namezis/WioLTE_Cat_NB1_Eagle/README.md

# WioLTE_Cat_NB1_Documents

Split [Wio LTE Cat NB1 v1.02.sch](https://github.com/namezis/WioLTE_Cat_NB1_Eagle/blob/master/eagle/Wio%20LTE%20Cat%20NB1%20v1.02%20-%20Schematic%20-%20ANNOTATE.pdf) into seperate pages.
