namezis/WioLTE_Cat_NB1_Eagle/eagle/Wio LTE Cat NB1 v1.02 - Page 1 - CHARGER.pdf

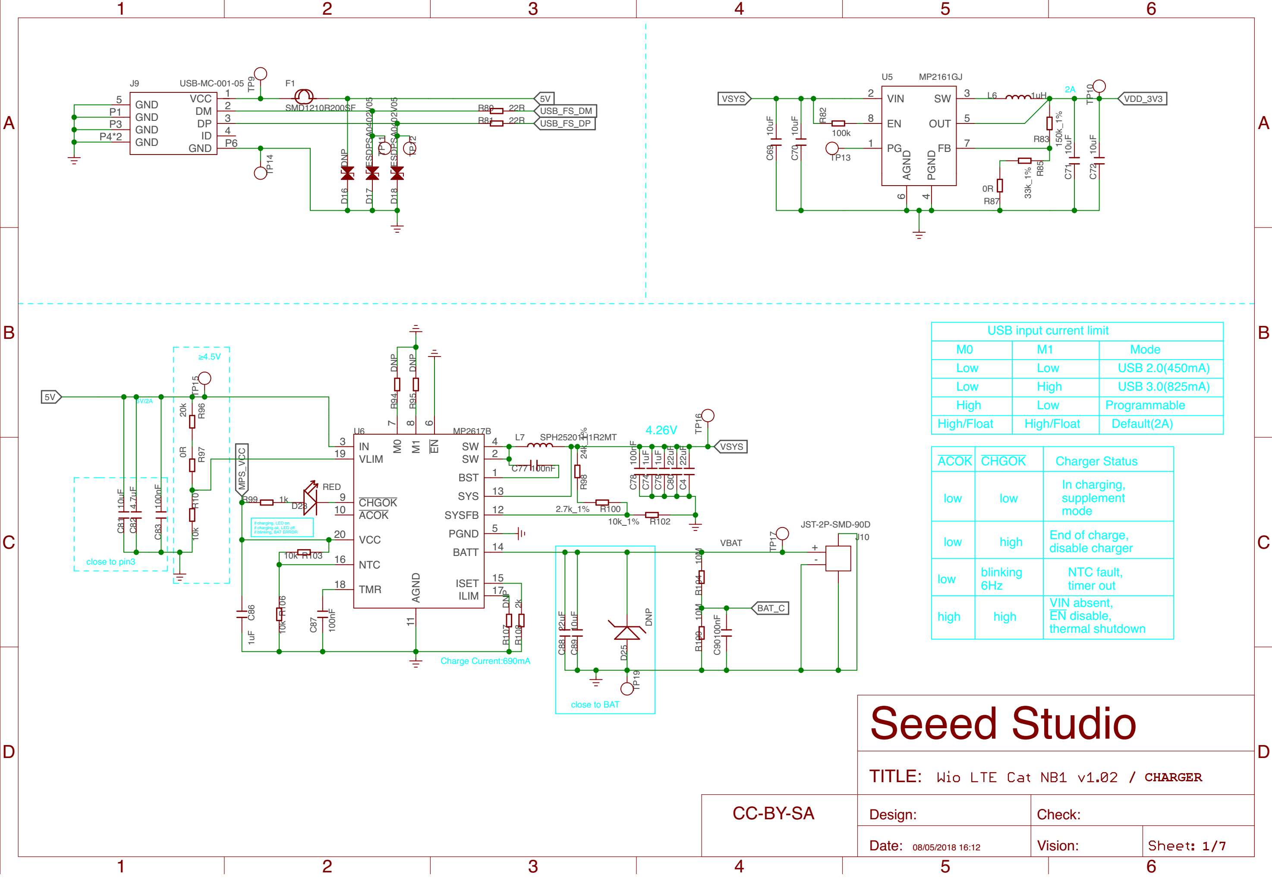
[picture p8: page 1]
