namezis/WioLTE_Cat_NB1_Eagle/eagle/Wio LTE Cat NB1 v1.02 - Page 2 - CPU.pdf

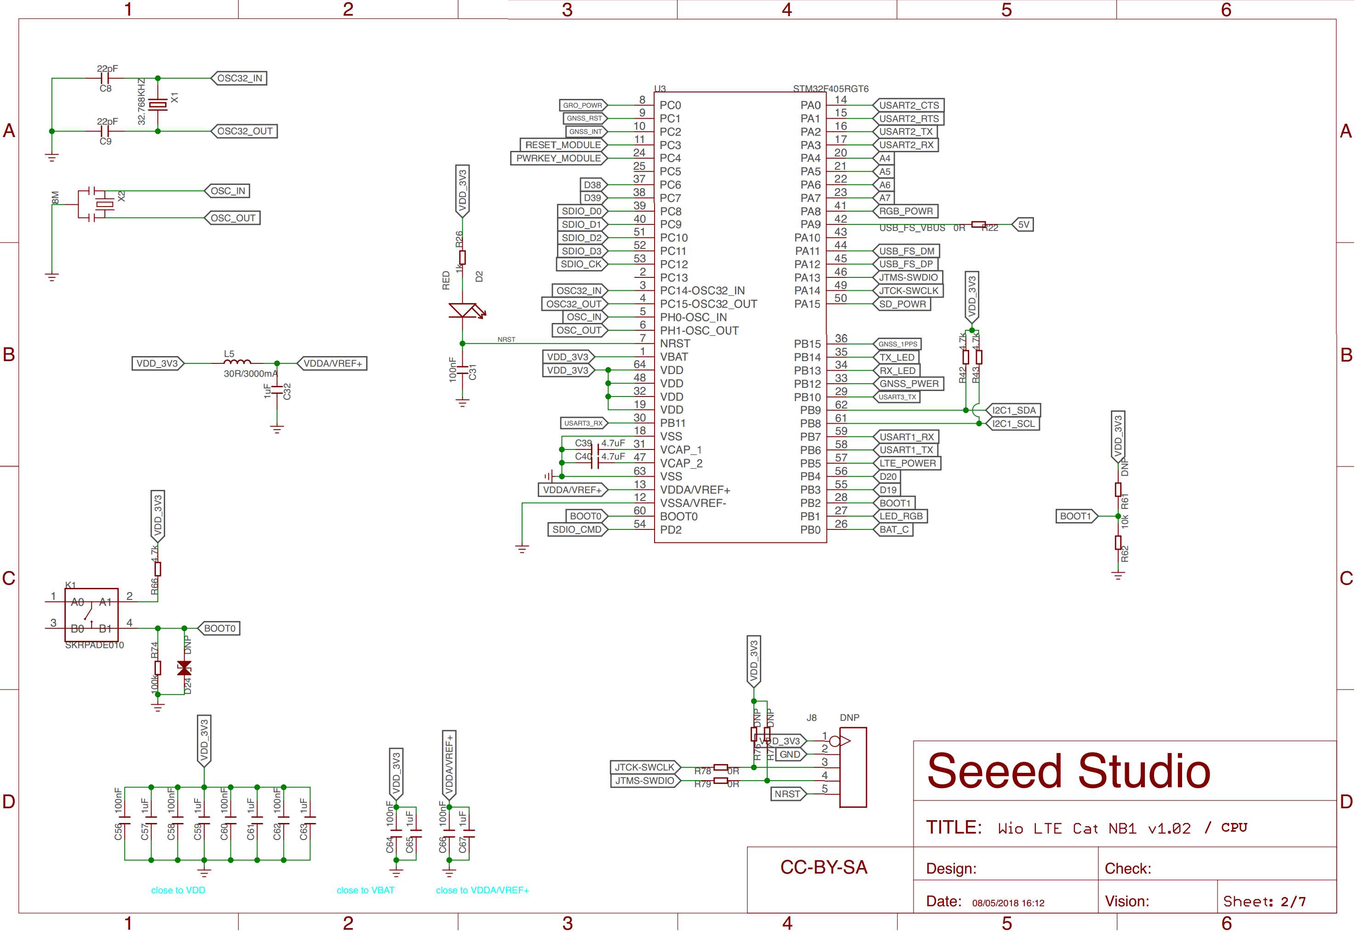
[picture p9: page 1]
