namezis/WioLTE_Cat_NB1_Eagle/eagle/Wio LTE Cat NB1 v1.02 - Page 3 - SARA.pdf

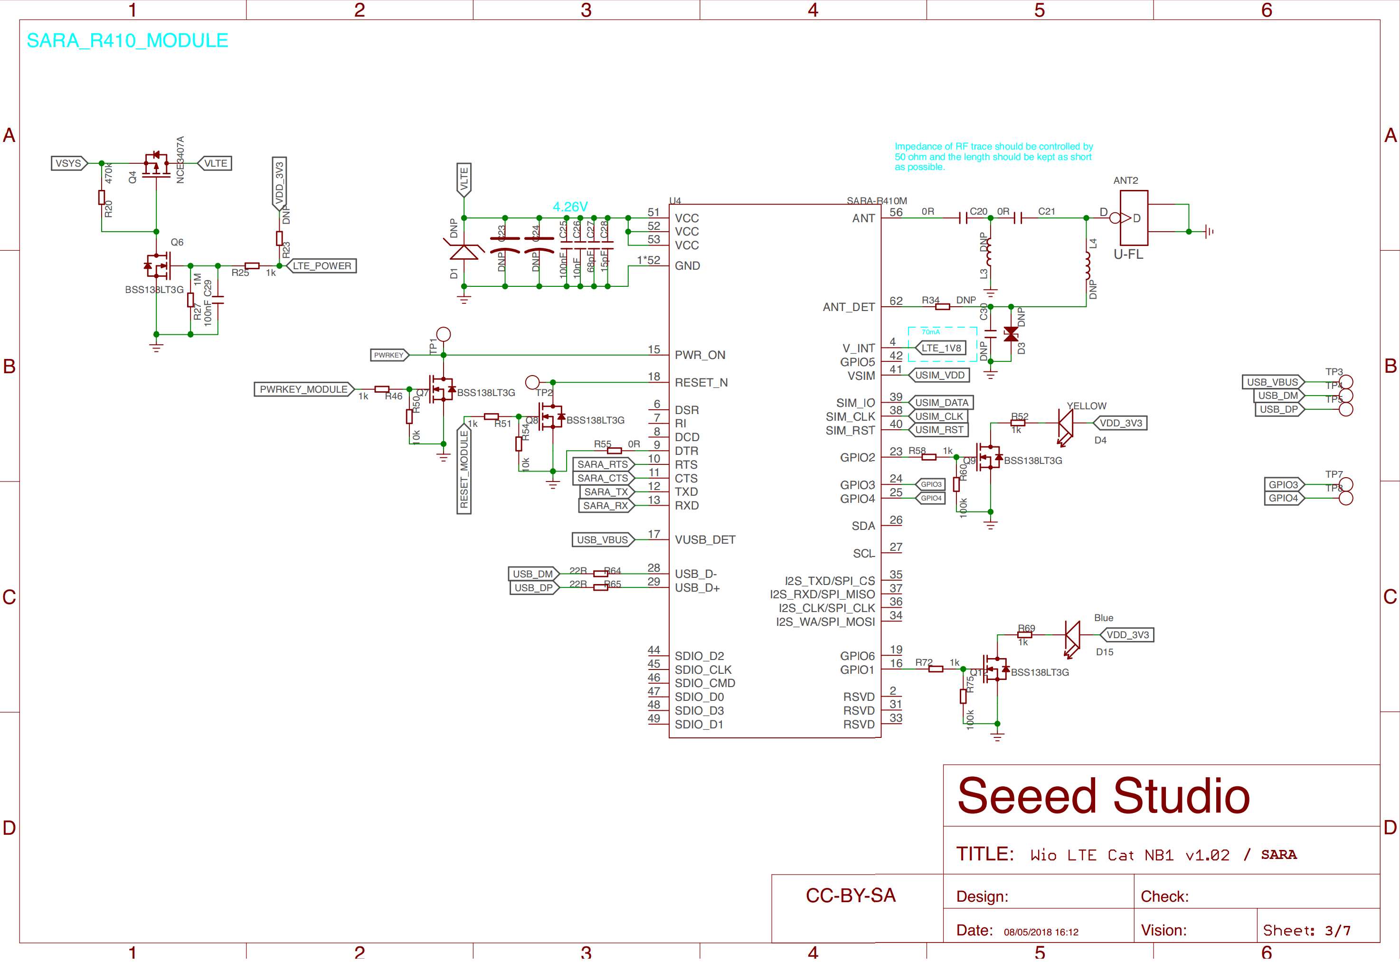
[picture p10: page 1]
