namezis/WioLTE_Cat_NB1_Eagle/eagle/Wio LTE Cat NB1 v1.02 - Page 4 - GPS.pdf

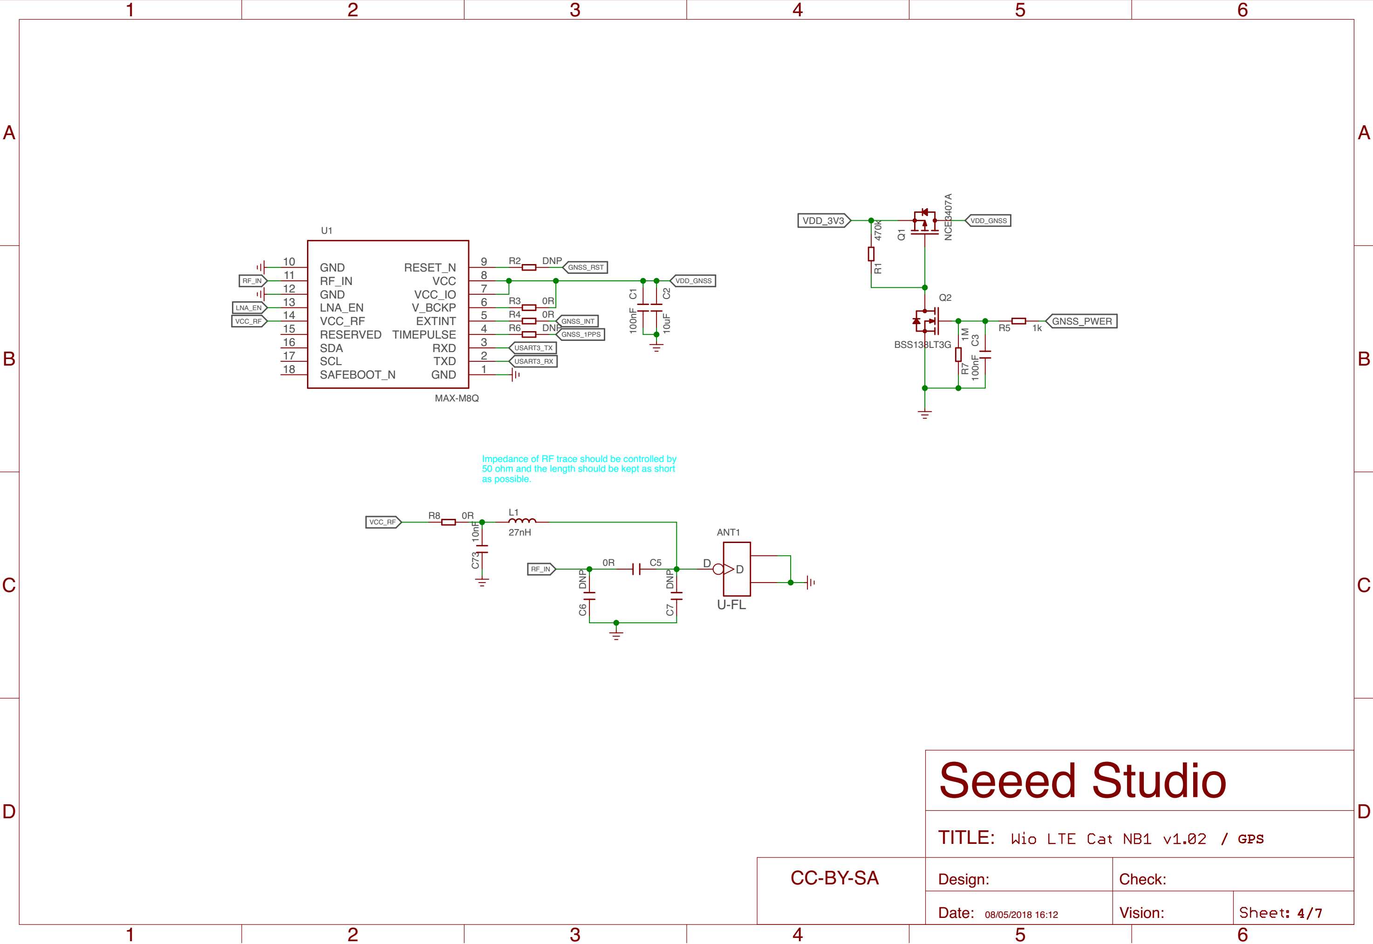
[picture p11: page 1]
