namezis/WioLTE_Cat_NB1_Eagle/eagle/Wio LTE Cat NB1 v1.02 - Page 5 - SIM_SD.pdf

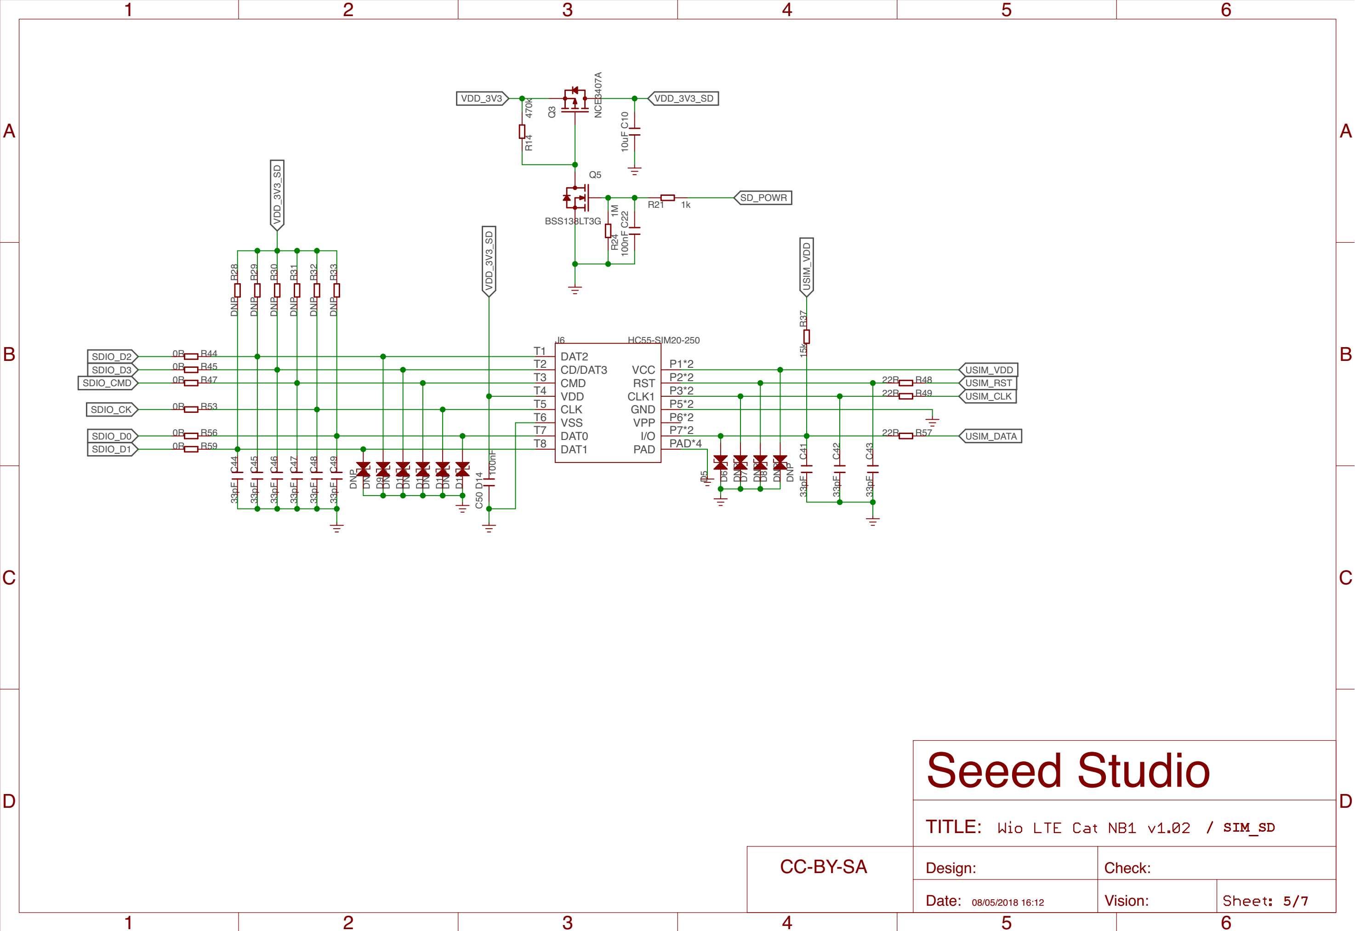
[picture p12: page 1]
