namezis/WioLTE_Cat_NB1_Eagle/eagle/Wio LTE Cat NB1 v1.02 - Page 6 - PERIPH.pdf

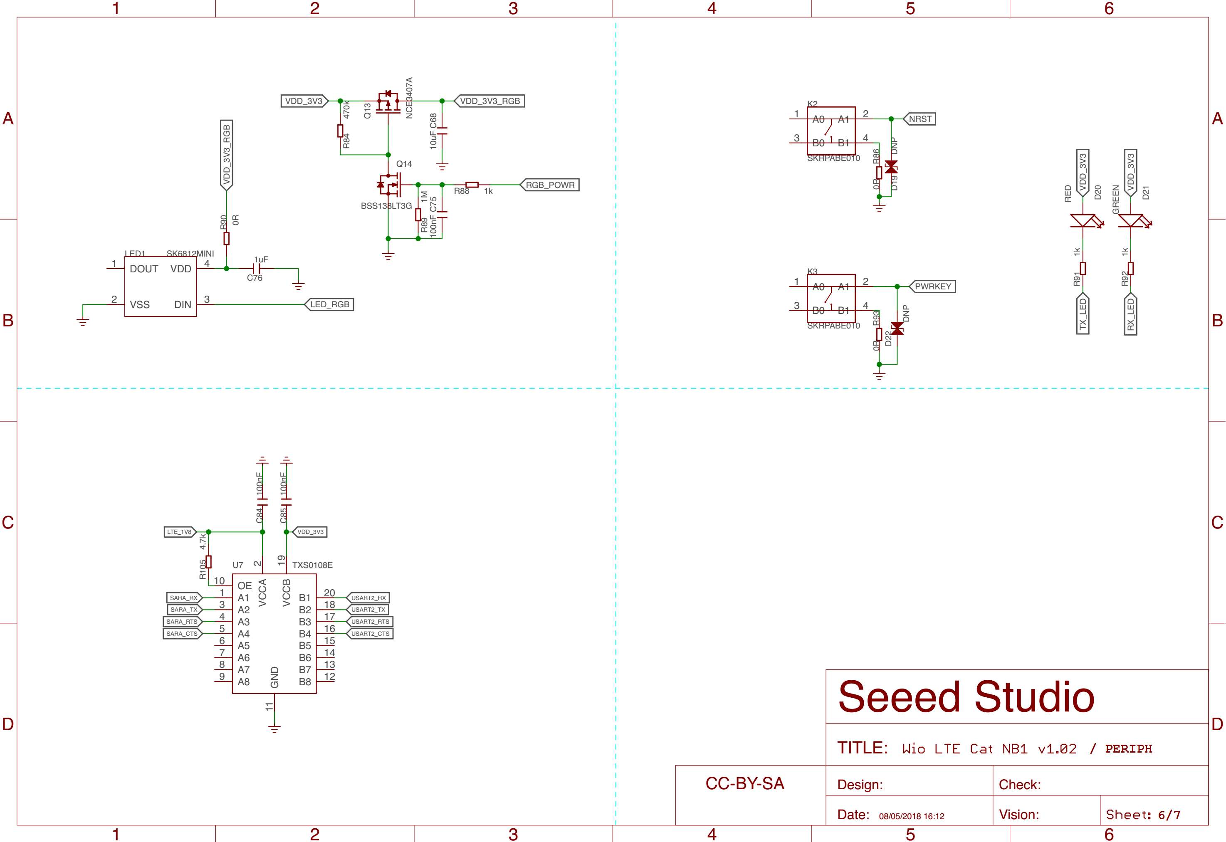
[picture p13: page 1]
