namezis/WioLTE_Cat_NB1_Eagle/eagle/Wio LTE Cat NB1 v1.02 - Page 7 - GROVE.pdf

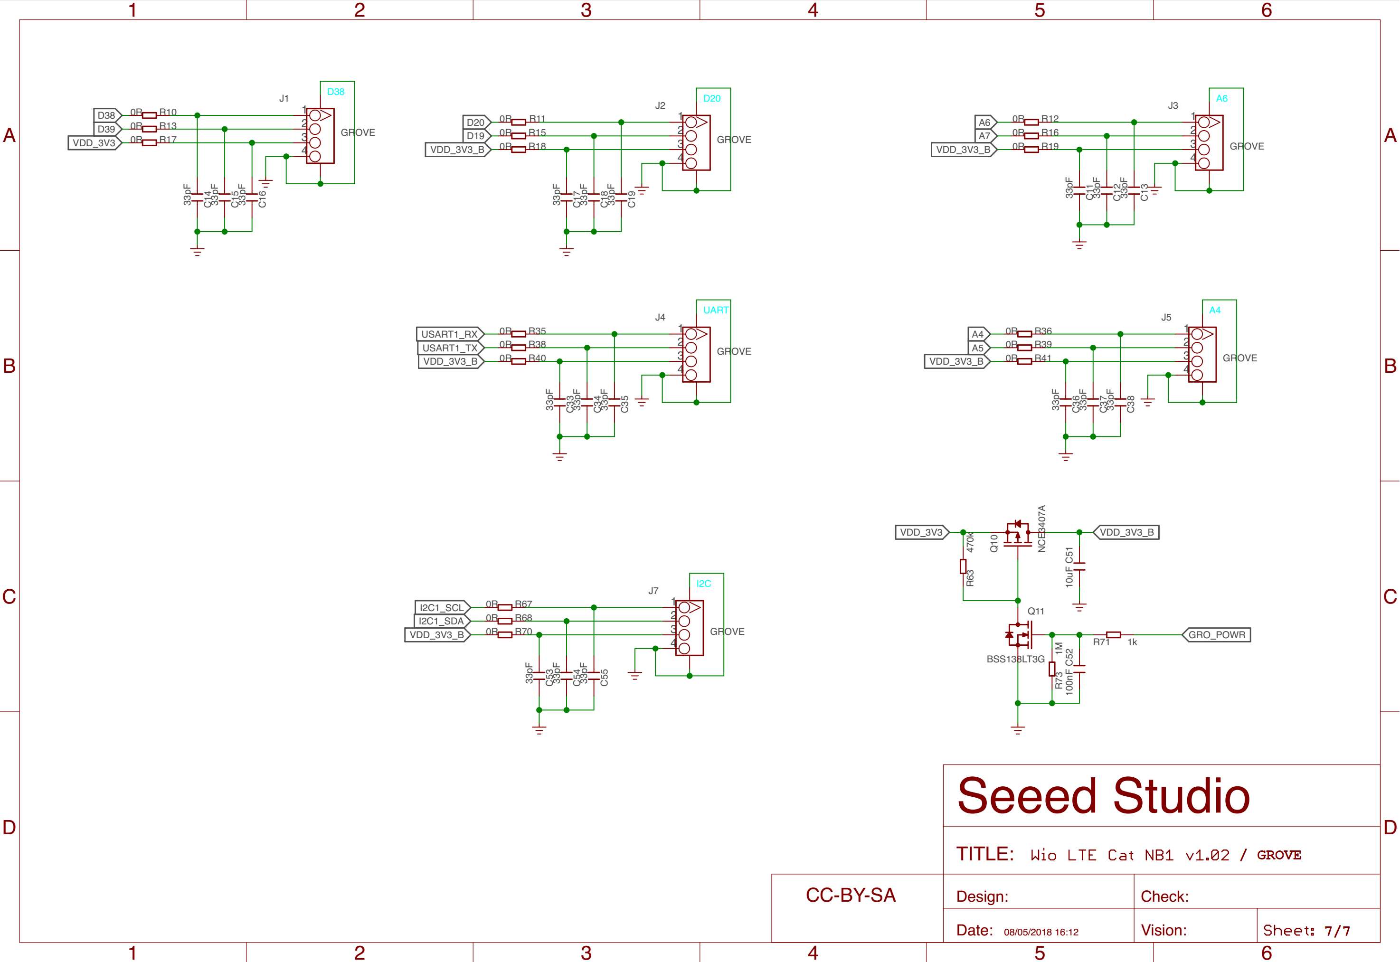
[picture p14: page 1]
