namezis/WioLTE_Cat_NB1_Eagle/eagle/Wio LTE Cat NB1 v1.02_SCH.pdf

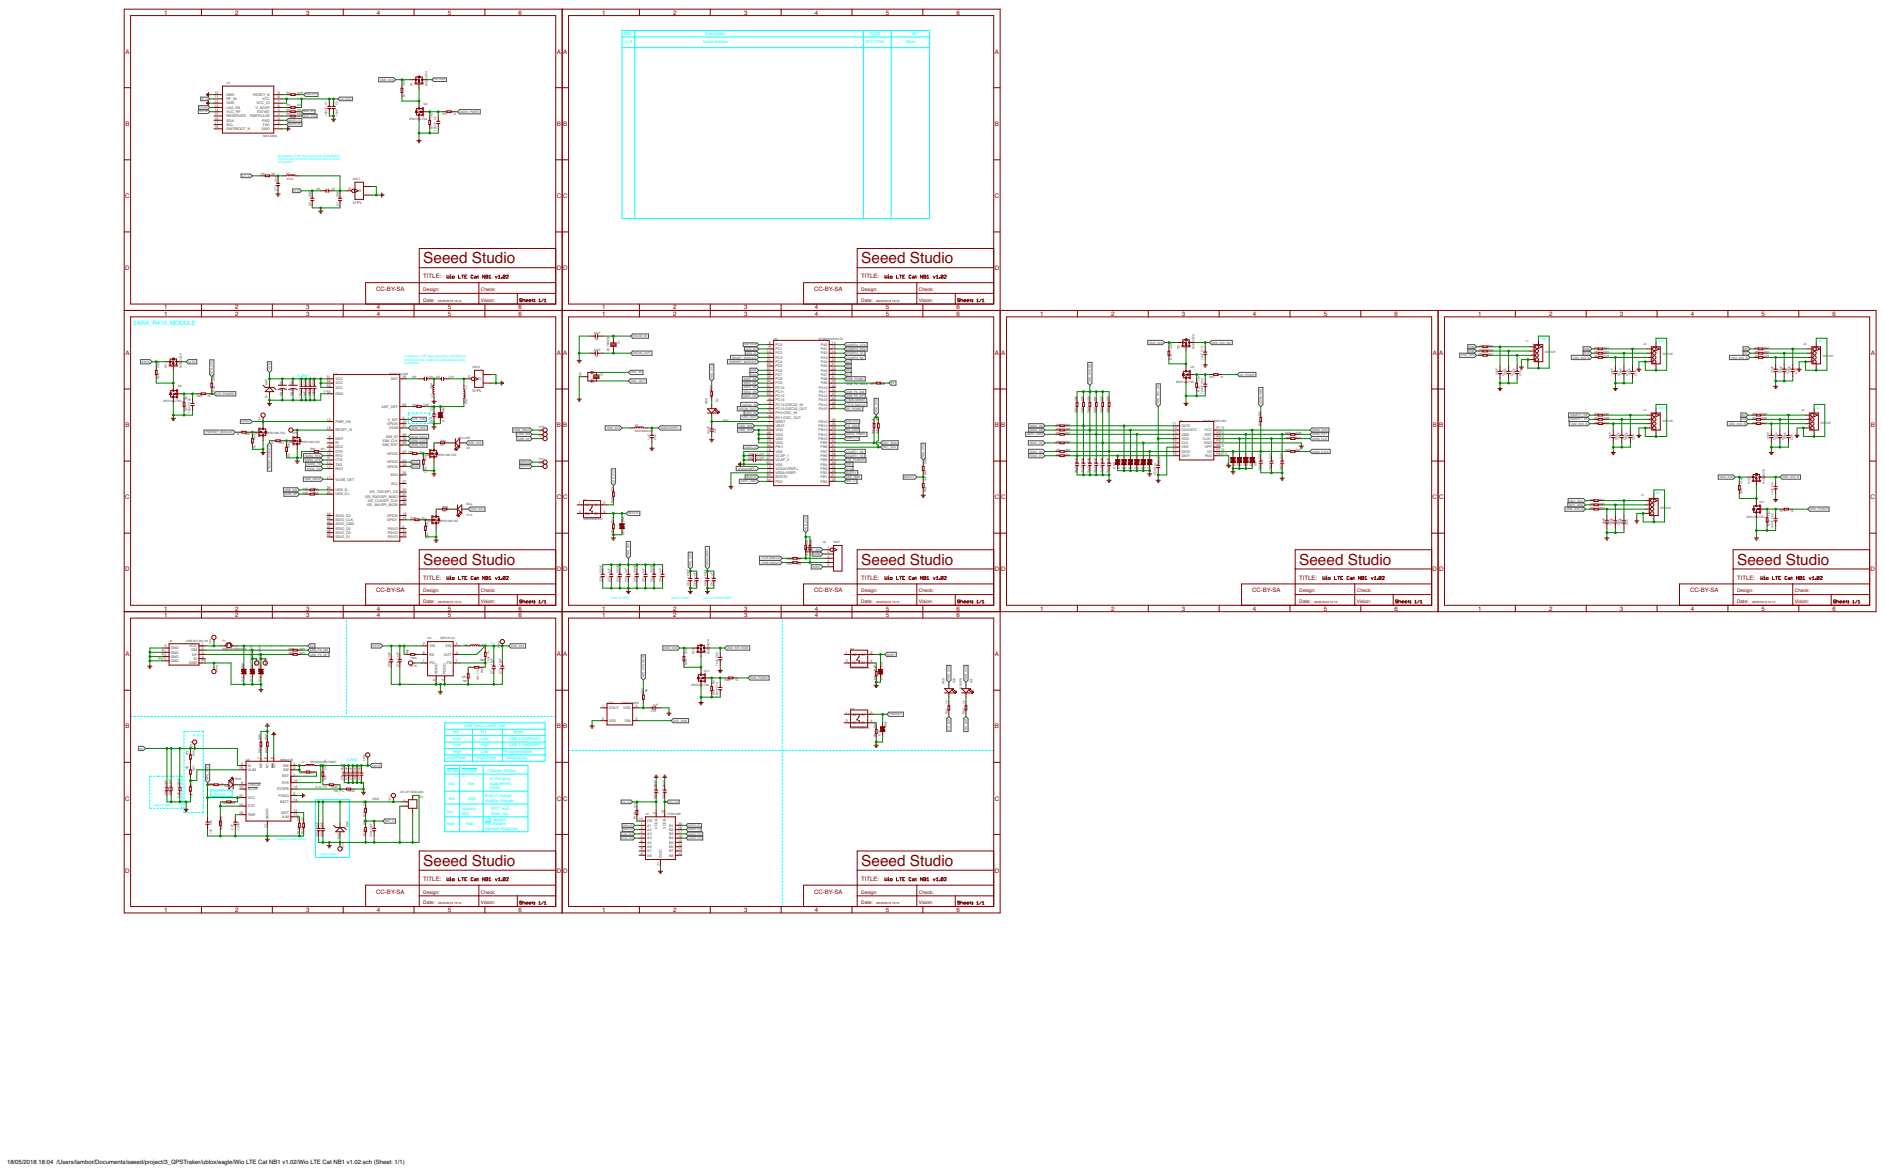
[picture p15: page 1]

REV | Description | DATE | BY

v1.0 | Initial release | 2017/7/24 | Myer

Impedance of RF trace should be controlled by 50 ohm and the length should be kept as short as possible.

DNP DNP

33pF DNP DNP DNP DNP

USB input current limit

M0 | M1 | Mode
Low | Low | USB 2.0(450mA)
Low | High | USB 3.0(825mA)
High | Low | Programmable Default(2A)
High/Float | High/Float

In charging, supplement mode End of charge, disable charger NTC fault,

if blinking, BAT ERROR close to pin3

if charging, LED on.
if charging ok, LED off.

low | blinking 6Hzhigh | timer out

high | | VIN absent, EN disable, thermal shutdown

18/05/2018 18:04 /Users/lambor/Documents/seeed/project/3_GPSTraker/ublox/eagle/Wio LTE Cat NB1 v1.02/Wio LTE Cat NB1 v1.02.sch (Sheet: 1/1)
