namezis/WioLTE_Cat_NB1_Eagle/eagle/Wio LTE Cat NB1 v1.02.brd

## EAGLE design eagle/Wio LTE Cat NB1 v1.02.brd (2018-05-18)

Schematic: Wio LTE Cat NB1 v1.02.sch

Parts:
ANT1, ANT2: U-FL; U-FL3P-SMD-2.6X2.6X1.0MM
C1, C3, C22, C25, C29, C31, C50, C52, C56, C58, C60, C62, C64, C66, C75, C77, C78, C83, C84, C85, C87, C90: 100nF; C0402
C2, C10, C51, C68, C69, C70, C71, C72, C89: 10uF; C0603
C4, C80, C88: 22uF; C0805
C5, C20, C21: 0R; C0402
C6, C7, C30: DNP; C0402
C8, C9: 22pF; C0402
C11, C12, C13, C14, C15, C16, C17, C18, C19, C33, C34, C35, C36, C37, C38, C41, C42, C43, C44, C45, C46, C47, C48, C49, C53, C54, C55: 33pF; C0402
C23, C24: DNP; AVX-D
C26, C73: 10nF; C0402
C27: 68pF; C0402
C28: 15pF; C0402
C32: 1uF; C0603
C39, C40: 4.7uF; C0402
C57, C59, C61, C63, C65, C67, C74, C76, C79, C86: 1uF; C0402
C81: 10uF; C0805
C82: 4.7uF; C0603
D1: DNP; SOD-123
D2, D20, D23: RED; LED-0402
D3, D5, D6, D7, D8, D9, D10, D11, D12, D13, D14, D16, D19, D22, D24: DNP; ESD-0402
D4: YELLOW; LED-0402
D15: Blue; LED-0402
D17, D18: ESDPSA0402V05; ESD-0402
D21: GREEN; LED-0402
D25: DNP; SOD-523
F1: SMD1210R200SF; F1210
FR1, FR2, FR3, FR4, FR5, FR6, FR7, FR8: SEEEDSTUDIO-OPEN-SCH-FRAME; SEEEDSTUDIO-PCB-FRAME
J1, J2, J3, J4, J5, J7: GROVE; HW4-SMD-2.0-90D
J6: HC55-SIM20-250; SIM+TF-24P-SMD-1.2-15.05X13.66X2.5MM
J8: DNP; H5-SMD-2.0-TEST
J9: USB-MC-001-05; MICRO-USB5+5P-SMD-0.65-7.2X5.06MM
J10: JST-2P-SMD-90D; HW2-SMD-2.0-90D
K1: SKRPADE010; SW4P-SMD-4.5X3.2X2.5MM
K2, K3: SKRPABE010; SW4P-SMD-4.5X3.2X2.5MM
L1: 27nH; L0402
L3, L4: DNP; L0402
L5: 30R/3000mA; L0603
L6: 1uH; L201610
L7: SPH25201H1R2MT; L2520
LED1: SK6812MINI; LED4-1.75-3.7X3.5X0.95MM
Q1, Q3, Q4, Q10, Q13: NCE3407A; SOT-23
Q2, Q5, Q6, Q7, Q8, Q9, Q11, Q12, Q14: BSS138LT3G; SOT-23
R1, R14, R20, R63, R84: 470k; R0402
R2, R6, R23, R28, R29, R30, R31, R32, R33, R34, R61, R76, R77, R94, R95, R107: DNP; R0402
R3, R4, R8, R10, R11, R12, R13, R15, R16, R17, R18, R19, R22, R35, R36, R38, R39, R40, R41, R44, R45, R47, R53, R55, R56, R59, R67, R68, R70, R78, R79, R86, R87, R90, R93, R97: 0R; R0402
R5, R21, R25, R26, R46, R51, R52, R58, R69, R71, R72, R88, R91, R92, R99: 1k; R0402
R7, R24, R27, R73, R89: 1M; R0402
R37: 15k; R0402
R42, R43, R66, R105: 4.7k; R0402
R48, R49, R57, R64, R65, R80, R81: 22R; R0402
R50, R54, R62, R101, R103, R106: 10k; R0402
R60, R74, R75, R82: 100k; R0402
R83: 150k_1%; R0402
R85: 33k_1%; R0402
R96: 20k; R0402
R98: 24k_1%; R0402
R100: 2.7k_1%; R0402
R102: 10k_1%; R0402
R104, R109: 10M; R0402
R108: 2k; R0402
TP1, TP2, TP3, TP4, TP5, TP7, TP8, TP9, TP10, TP11, TP12, TP13, TP14, TP15, TP16, TP17, TP19: TEST-POINT'4545'; TP-D45MIL
U1: MAX-M8Q; LGA18-1.1-9.7X10.1X2.5MM
U3: STM32F405RGT6; LQFP64
U4: SARA-R410M; MOUDLE96P-SMD-1.1-26X16X2.53MM
U5: MP2161GJ; TSOT23-8
U6: MP2617B; QFN20-0.5-3X4X1MM
U7: TXS0108E; TSSOP20-0.65-6.5X4.4MM
X1: 32.768KHZ; X2-SMD-L2.0X1.2X0.55MM
X2: 8M; RESONATOR3-SMD-3.6X1.3X0.8MM

Connections:
5V: C81.1, C82.1, C83.1, D16.2, F1.2, R22.1, R96.1, TP15.T, U6.3 (IN)
A4: R36.2, U3.20 (PA4)
A5: R39.2, U3.21 (PA5)
A6: R12.2, U3.22 (PA6)
A7: R16.2, U3.23 (PA7)
BAT_C: C90.1, R104.1, R109.2, U3.26 (PB0)
BOOT0: D24.2, K1.4 (B1), R74.1, U3.60 (BOOT0)
BOOT1: R61.1, R62.2, U3.28 (PB2)
CD/DATA3: C46.1, D11.2, J6.T2 (CD/DAT3), R30.2, R45.1
D19: R15.2, U3.55 (PB3)
D20: R11.2, U3.56 (PB4)
D38: R10.2, U3.37 (PC6)
D39: R13.2, U3.38 (PC7)
GND: ANT1.GND1, ANT1.GND2, ANT2.GND1, ANT2.GND2, C1.2, C2.2, C3.2, C4.1, C6.1, C7.1, C8.2, C9.2, C10.2, C11.2, C12.2, C13.2, C14.2, C15.2, C16.2, C17.2, C18.2, C19.2, C22.2, C23.-, C24.-, C25.1, C26.1, C27.1, C28.1, C29.2, C30.2, C31.2, C32.2, C33.2, C34.2, C35.2, C36.2, C37.2, C38.2, C39.1, C40.1, C41.2, C42.2, C43.2, C44.2, C45.2, C46.2, C47.2, C48.2, C49.2, C50.1, C51.2, C52.2, C53.2, C54.2, C55.2, C56.1, C57.1, C58.1, C59.1, C60.1, C61.1, C62.1, C63.1, C64.1, C65.1, C66.1, C67.1, C68.2, C69.1, C70.1, C71.1, C72.1, C73.1, C74.1, C75.2, C76.1, C78.1, C79.1, C80.1, C81.2, C82.2, C83.2, C84.1, C85.1, C86.1, C87.1, C88.2, C89.2, C90.2, D1.+, D3.1, D5.1, D6.1, D7.1, D8.1, D9.1, D10.1, D11.1, D12.1, D13.1, D14.1, D16.1, D17.1, D18.1, D19.1, D22.1, D24.1, D25.+, J1.4, J1.SS1, J1.SS2, J2.4, J2.SS1, J2.SS2, J3.4, J3.SS1, J3.SS2, J4.4, J4.SS1, J4.SS2, J5.4, J5.SS1, J5.SS2, J6.P5 (GND), J6.P5B (GND), J6.PAD, J6.PAD1 (PAD), J6.PAD2 (PAD), J6.PAD3 (PAD), J6.T6 (VSS), J7.4, J7.SS1, J7.SS2, J8.2, J9.5 (GND), J9.P1 (GND), J9.P3 (GND), J9.P4 (GND), J9.P5 (GND), J9.P6 (GND), J10.3, J10.4, J10.- (2), L3.1, LED1.2 (VSS), Q2.2 (S), Q5.2 (S), Q6.2 (S), Q7.2 (S), Q8.2 (S), Q9.2 (S), Q11.2 (S), Q12.2 (S), Q14.2 (S), R7.1, R24.1, R27.1, R50.2, R54.2, R55.1, R60.2, R62.1, R73.1, R74.2, R75.2, R86.2, R87.1, R89.1, R93.2, R94.2, R95.2, R101.2, R102.1, R106.2, R107.1, R108.1, R109.1, TP14.T, TP19.T, U1.1 (GND), U1.10 (GND), U1.12 (GND), U3.12 (VSSA/VREF-), U3.18 (VSS), U3.63 (VSS), U4.1 (GND), U4.3 (GND), U4.5 (GND), U4.14 (GND), U4.20 (GND), U4.21 (GND), U4.22 (GND), U4.30 (GND), U4.32 (GND), U4.43 (GND), U4.50 (GND), U4.54 (GND), U4.55 (GND), U4.57 (GND), U4.58 (GND), U4.59 (GND), U4.60 (GND), U4.61 (GND), U4.63 (GND), U4.64 (GND), U4.65 (GND), U4.66 (GND), U4.67 (GND), U4.68 (GND), U4.69 (GND), U4.70 (GND), U4.71 (GND), U4.72 (GND), U4.73 (GND), U4.74 (GND), U4.75 (GND), U4.76 (GND), U4.77 (GND), U4.78 (GND), U4.79 (GND), U4.80 (GND), U4.81 (GND), U4.82 (GND), U4.83 (GND), U4.84 (GND), U4.85 (GND), U4.86 (GND), U4.87 (GND), U4.88 (GND), U4.89 (GND), U4.90 (GND), U4.91 (GND), U4.92 (GND), U4.93 (GND), U4.94 (GND), U4.95 (GND), U4.96 (GND), U5.4 (PGND), U5.6 (AGND), U6.5 (PGND), U6.6 (!EN), U6.11 (AGND), U7.11 (GND), X2.2
GNSS_1PPS: R6.2, U3.36 (PB15)
GNSS_INT: R4.2, U3.10 (PC2)
GNSS_PWER: R5.2, U3.33 (PB12)
GNSS_RST: R2.2, U3.9 (PC1)
GPIO3: TP7.T, U4.24 (GPIO3)
GPIO4: TP8.T, U4.25 (GPIO4)
GRO_POWR: R71.2, U3.8 (PC0)
I2C1_SCL: R43.1, R67.2, U3.61 (PB8)
I2C1_SDA: R42.1, R68.2, U3.62 (PB9)
JTCK-SWCLK: R78.1, U3.49 (PA14)
JTMS-SWDIO: R79.1, U3.46 (PA13)
LED_RGB: LED1.3 (DIN), U3.27 (PB1)
LNA_EN: U1.13 (LNA_EN)
LTE_1V8: C84.2, R105.2, U4.4 (V_INT), U7.2 (VCCA)
LTE_POWER: R23.1, R25.2, U3.57 (PB5)
MPS_VCC: C86.2, R99.1, R103.1, U6.20 (VCC)
unnamed: C73.2, L1.1, R8.2
unnamed: TP13.T, U5.1 (PG)
unnamed: K3.4 (B1), R93.1
unnamed: R64.1, U4.28 (USB_D-)
unnamed: R65.1, U4.29 (USB_D+)
unnamed: D20.-, R91.2
unnamed: C76.2, LED1.4 (VDD), R90.2
unnamed: C75.1, Q14.1 (G), R88.1, R89.2
unnamed: R103.2, R106.1, U6.16 (NTC)
unnamed: C20.2, U4.56 (ANT)
unnamed: D2.+, R26.2
unnamed: K2.4 (B1), R86.1
unnamed: Q13.1 (G), Q14.3 (D), R84.1
unnamed: Q7.1 (G), R46.1, R50.1
unnamed: C39.2, U3.31 (VCAP_1)
unnamed: C40.2, U3.47 (VCAP_2)
unnamed: J8.3, R76.1, R78.2
unnamed: J8.4, R77.1, R79.2
unnamed: R98.1, R100.2
unnamed: R100.1, R102.2, U6.12 (SYSFB)
unnamed: F1.1, J9.1 (VCC), TP9.T
unnamed: Q4.1 (G), Q6.3 (D), R20.1
unnamed: C29.1, Q6.1 (G), R25.1, R27.2
unnamed: Q8.1 (G), R51.1, R54.1
unnamed: Q8.3 (D), TP2.T, U4.18 (RESET_N)
unnamed: Q12.1 (G), R72.2, R75.1
unnamed: C87.2, U6.18 (TMR)
unnamed: K1.2 (A1), R66.1
unnamed: C77.2, L7.1, U6.2 (SW), U6.4 (SW)
unnamed: C45.1, D10.2, J6.T1 (DAT2), R29.2, R44.1
unnamed: C44.1, D9.2, J6.T8 (DAT1), R28.2, R59.1
unnamed: R107.2, U6.17 (ILIM)
unnamed: R108.2, U6.15 (ISET)
unnamed: R72.1, U4.16 (GPIO1)
unnamed: R58.1, U4.23 (GPIO2)
unnamed: C77.1, U6.1 (BST)
unnamed: C53.1, J7.3, R70.1
unnamed: R96.2, R97.1
unnamed: C54.1, J7.2, R68.1
unnamed: Q9.1 (G), R58.2, R60.1
unnamed: C55.1, J7.1, R67.1
unnamed: R55.2, U4.9 (DTR)
unnamed: C16.1, J1.3, R17.1
unnamed: R85.2, R87.2
unnamed: L6.1, U5.3 (SW)
unnamed: Q9.3 (D), R52.1
unnamed: C15.1, J1.2, R13.1
unnamed: D18.2, J9.3 (DP), R81.1, TP12.T
unnamed: C14.1, J1.1, R10.1
unnamed: D17.2, J9.2 (DM), R80.1, TP11.T
unnamed: D21.-, R92.2
unnamed: Q12.3 (D), R69.1
unnamed: C20.1, C21.2, L3.2
unnamed: C43.1, D7.2, J6.P2 (RST), J6.P2B (RST), R48.2
unnamed: C42.1, D6.2, J6.P3 (CLK1), J6.P3B (CLK1), R49.2
unnamed: R34.1, U4.62 (ANT_DET)
unnamed: C41.1, D5.2, J6.P7 (I/O), J6.P7B (I/O), R37.2, R57.2
unnamed: C17.1, J2.3, R18.1
unnamed: C18.1, J2.2, R15.1
unnamed: C19.1, J2.1, R11.1
unnamed: C30.1, D3.2, L4.2, R34.2
unnamed: C11.1, J3.3, R19.1
unnamed: Q3.1 (G), Q5.3 (D), R14.1
unnamed: C12.1, J3.2, R16.1
unnamed: C13.1, J3.1, R12.1
unnamed: C33.1, J4.3, R40.1
unnamed: R82.2, U5.8 (EN)
unnamed: C34.1, J4.2, R38.1
unnamed: C35.1, J4.1, R35.1
unnamed: C36.1, J5.3, R41.1
unnamed: C37.1, J5.2, R39.1
unnamed: C38.1, J5.1, R36.1
unnamed: R83.1, R85.1, U5.7 (FB)
unnamed: Q10.1 (G), Q11.3 (D), R63.1
unnamed: C52.1, Q11.1 (G), R71.1, R73.2
unnamed: R97.2, R101.1, U6.19 (VLIM)
unnamed: R94.1, U6.7 (M0)
unnamed: R95.1, U6.8 (M1)
unnamed: C22.1, Q5.1 (G), R21.1, R24.2
unnamed: Q1.1 (G), Q2.3 (D), R1.1
unnamed: D23.-, U6.9 (!CHGOK)
unnamed: D23.+, R99.2
unnamed: ANT1.D, C5.1, C7.2, L1.2
unnamed: ANT2.D, C21.1, L4.1
unnamed: D4.-, R52.2
unnamed: R2.1, U1.9 (RESET_N)
unnamed: R3.1, U1.6 (V_BCKP)
unnamed: R4.1, U1.5 (EXTINT)
unnamed: R6.1, U1.4 (TIMEPULSE)
unnamed: D15.-, R69.2
unnamed: C3.1, Q2.1 (G), R5.1, R7.2
NRST: C31.1, D2.-, D19.2, J8.5, K2.2 (A1), U3.7 (NRST)
OE: R105.1, U7.10 (OE)
OSC32_IN: C8.1, U3.3 (PC14-OSC32_IN), X1.1
OSC32_OUT: C9.1, U3.4 (PC15-OSC32_OUT), X1.2
OSC_IN: U3.5 (PH0-OSC_IN), X2.1
OSC_OUT: U3.6 (PH1-OSC_OUT), X2.3
PWRKEY: D22.2, K3.2 (A1), Q7.3 (D), TP1.T, U4.15 (PWR_ON)
PWRKEY_MODULE: R46.2, U3.24 (PC4)
RESET_MODULE: R51.2, U3.11 (PC3)
RF_IN: C5.2, C6.2, U1.11 (RF_IN)
RGB_POWR: R88.2, U3.41 (PA8)
RX_LED: R92.1, U3.34 (PB13)
SARA_CTS: U4.11 (CTS), U7.5 (A4)
SARA_RTS: U4.10 (RTS), U7.4 (A3)
SARA_RX: U4.13 (RXD), U7.1 (A1)
SARA_TX: U4.12 (TXD), U7.3 (A2)
SDIO_CK: R53.2, U3.53 (PC12)
SDIO_CMD: R47.2, U3.54 (PD2)
SDIO_D0: R56.2, U3.39 (PC8)
SDIO_D1: R59.2, U3.40 (PC9)
SDIO_D2: R44.2, U3.51 (PC10)
SDIO_D3: R45.2, U3.52 (PC11)
SD_CLK: C48.1, D13.2, J6.T5 (CLK), R32.2, R53.1
SD_CMD: C47.1, D12.2, J6.T3 (CMD), R31.2, R47.1
SD_DATA0: C49.1, D14.2, J6.T7 (DAT0), R33.2, R56.1
SD_POWR: R21.2, U3.50 (PA15)
TX_LED: R91.1, U3.35 (PB14)
USART1_RX: R35.2, U3.59 (PB7)
USART1_TX: R38.2, U3.58 (PB6)
USART2_CTS: U3.14 (PA0), U7.16 (B4)
USART2_RTS: U3.15 (PA1), U7.17 (B3)
USART2_RX: U3.17 (PA3), U7.20 (B1)
USART2_TX: U3.16 (PA2), U7.18 (B2)
USART3_RX: U1.2 (TXD), U3.30 (PB11)
USART3_TX: U1.3 (RXD), U3.29 (PB10)
USB_DM: R64.2, TP4.T
USB_DP: R65.2, TP5.T
USB_FS_DM: R80.2, U3.44 (PA11)
USB_FS_DP: R81.2, U3.45 (PA12)
USB_FS_VBUS: R22.2, U3.42 (PA9)
USB_VBUS: TP3.T, U4.17 (VUSB_DET)
USIM_CLK: R49.1, U4.38 (SIM_CLK)
USIM_DATA: R57.1, U4.39 (SIM_IO)
USIM_RST: R48.1, U4.40 (SIM_RST)
USIM_VDD: D8.2, J6.P1 (VCC), J6.P1B (VCC), R37.1, U4.41 (VSIM)
VBAT: C88.1, C89.1, D25.-, J10.+ (1), R104.2, TP17.T, U6.14 (BATT)
VCC_RF: R8.1, U1.14 (VCC_RF)
VDDA/VREF+: C32.1, C66.2, C67.2, L5.2, U3.13 (VDDA/VREF+)
VDD_3V3: C56.2, C57.2, C58.2, C59.2, C60.2, C61.2, C62.2, C63.2, C64.2, C65.2, C71.2, C72.2, C85.2, D4.+, D15.+, D20.+, D21.+, J8.1, L5.1, L6.2, Q1.2 (S), Q3.2 (S), Q10.2 (S), Q13.2 (S), R1.2, R14.2, R17.2, R23.2, R26.1, R42.2, R43.2, R61.2, R63.2, R66.2, R76.2, R77.2, R83.2, R84.2, TP10.T, U3.1 (VBAT), U3.19 (VDD), U3.32 (VDD), U3.48 (VDD), U3.64 (VDD), U5.5 (OUT), U7.19 (VCCB)
VDD_3V3_B: C51.1, Q10.3 (D), R18.2, R19.2, R40.2, R41.2, R70.2
VDD_3V3_RGB: C68.1, Q13.3 (D), R90.1
VDD_3V3_SD: C10.1, C50.2, J6.T4 (VDD), Q3.3 (D), R28.1, R29.1, R30.1, R31.1, R32.1, R33.1
VDD_GNSS: C1.1, C2.1, Q1.3 (D), R3.2, U1.7 (VCC_IO), U1.8 (VCC)
VLTE: C23.+, C24.+, C25.2, C26.2, C27.2, C28.2, D1.-, Q4.3 (D), U4.51 (VCC), U4.52 (VCC), U4.53 (VCC)
VSYS: C4.2, C69.2, C70.2, C74.2, C78.2, C79.2, C80.2, L7.2, Q4.2 (S), R20.2, R82.1, R98.2, TP16.T, U5.2 (VIN), U6.13 (SYS)

Notes on the sheet:
SARA_R410_MODULE
close to VDD
close to VBAT
close to VDDA/VREF+
Initial release
v1.0
2017/7/24
Myer
close to BAT
5V/2A
if charging, LED on. if charging ok, LED off. if blinking, BAT ERROR
close to pin3
≥4.5V
Charge Current:690mA
!ACOK
!CHGOK
Charger Status
low
high
blinking 6Hz
In charging, supplement mode
End of charge, disable charger
NTC fault, timer out
VIN absent, !EN! disable, thermal shutdown
Mode
Low
High
High/Float
USB 2.0(450mA)
USB 3.0(825mA)
Programmable
Default(2A)
USB input current limit
4.26V
70mA
Impedance of RF trace should be controlled by 50 ohm and the length should be kept as short as possible.
D38
D20
UART
I2C

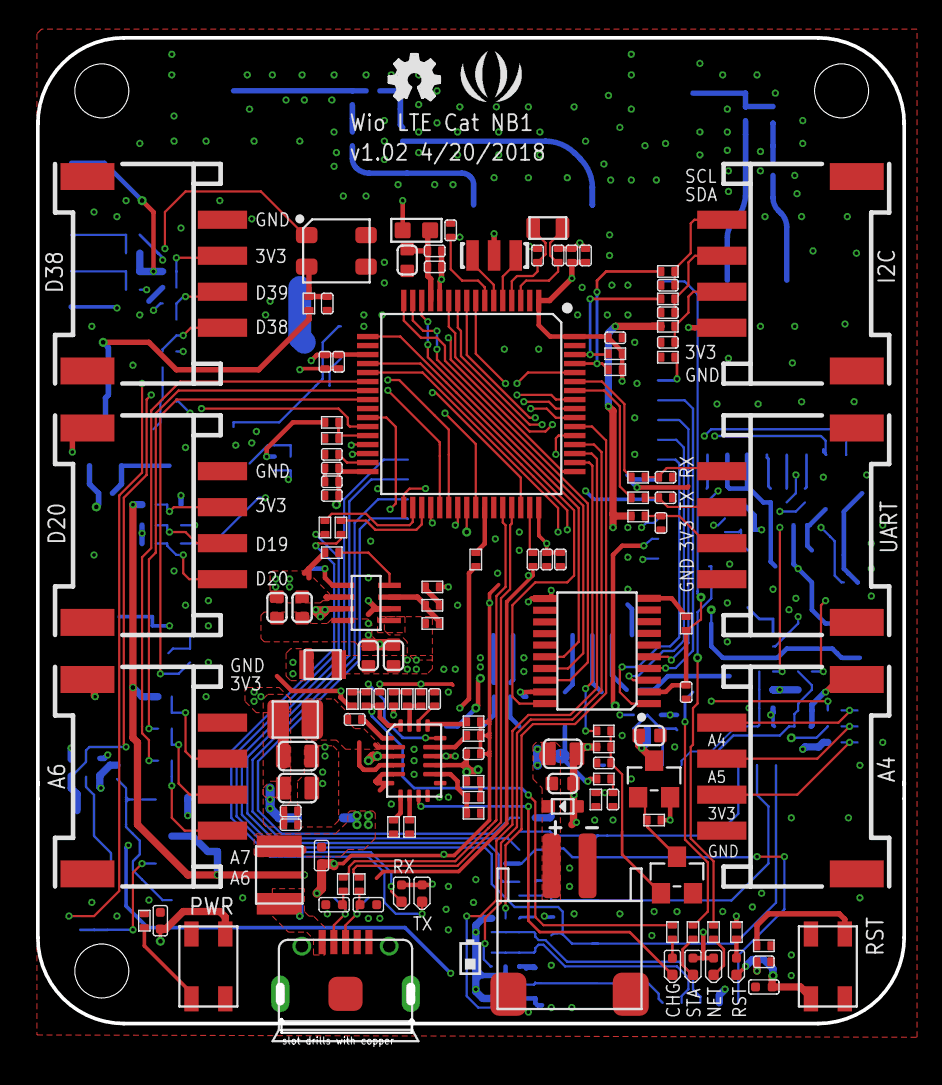
[picture p16: board Wio LTE Cat NB1 v1.02.brd from above]

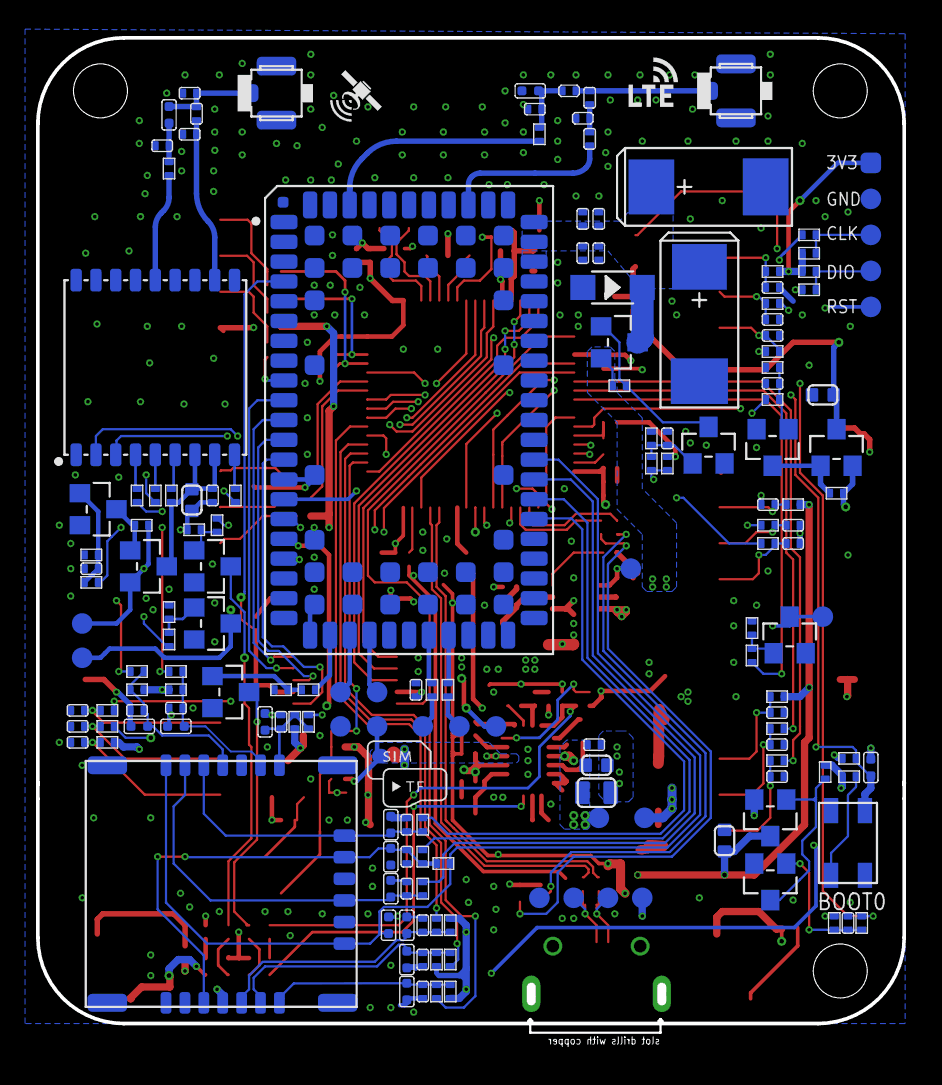
[picture p17: board Wio LTE Cat NB1 v1.02.brd from below]

Board: 4 copper layers, 48.1 x 55.3 mm, 295 parts (161 on the bottom side), 175 nets.

Other parts of the board:
U$97: OSHW_FILLX100_NOTEXT
U$98: SEEED-SILK--TNAME-160*153MIL
