namezis/WioLTE_Cat_NB1_Eagle/(commit log)

2018-05-18 Create Wio LTE Cat NB1 v1.02.sch
    [Wio LTE Cat NB1 v1.02.sch]
2018-09-16 Add schematics with annotations. Cross check all nets.
